viniciuscostass/sistema_irrigacao/Sistema de Irrigação e Caixas D'agua.pdf

# Sistema de Controle de Nível de Tanques e

Irrigaçao Autom ˜ | atica ´

Igor Theotonio ˆ
Instituto de Computaçaõ
Universidade Federal de Alagoas Maceio, Brasil ´
icat@ic.ufal.br

Marcos Vinícius Costa
Instituto de Computaçaõ
Universidade Federal de Alagoas Maceio, Brasil ´
mvsc@ic.ufal.br

Resumo—O artigo descreve a implementaçao de um sistema ˜
de controle de nível de tanques e irrigaçao autom ˜ | atica realizado ´
com Arduíno Genuíno Uno, construído como projeto final para
as disciplinas de Instrumentaçao Eletr ˜ | onica e Microcontroladores ˆ
e suas aplicaçoes do curso de Bacharelado em Engenharia de ˜ Computaçao - IC/UFAL. ˜
Palavras-chave—arduino, | sensores, | bomba | hidraulica, ´
irrigaçao, n ˜ | ível
I. INTRODUÇ AÕ

Com o avanço das tecnologias e civilizaçoes, diversos temas ˜ que outrora ignorados estao aparecendo com força total nas ˜ discussoes cotidianas e pensar em sustentabilidade foi ponto ˜ de partida na concepçao do projeto. ˜
Uma das maiores fontes de desperdício de agua no planeta ´
e a agricultura, sendo respons ´ | avel por mais de 70% do ´
consumo de agua do planeta [1]. Desta forma, o intutito ´ do projeto representado na figura 1 e demonstrar alternativas ´
financeiramente viaveis para diminuiç ´ | ao do uso de ˜ | agua na ´
agricultura de maneira simples, bem como demonstrar os conhecimentos adiquiridos nas disciplinas de instrumentaçaõ eletronica e microcontroladores. ˆ

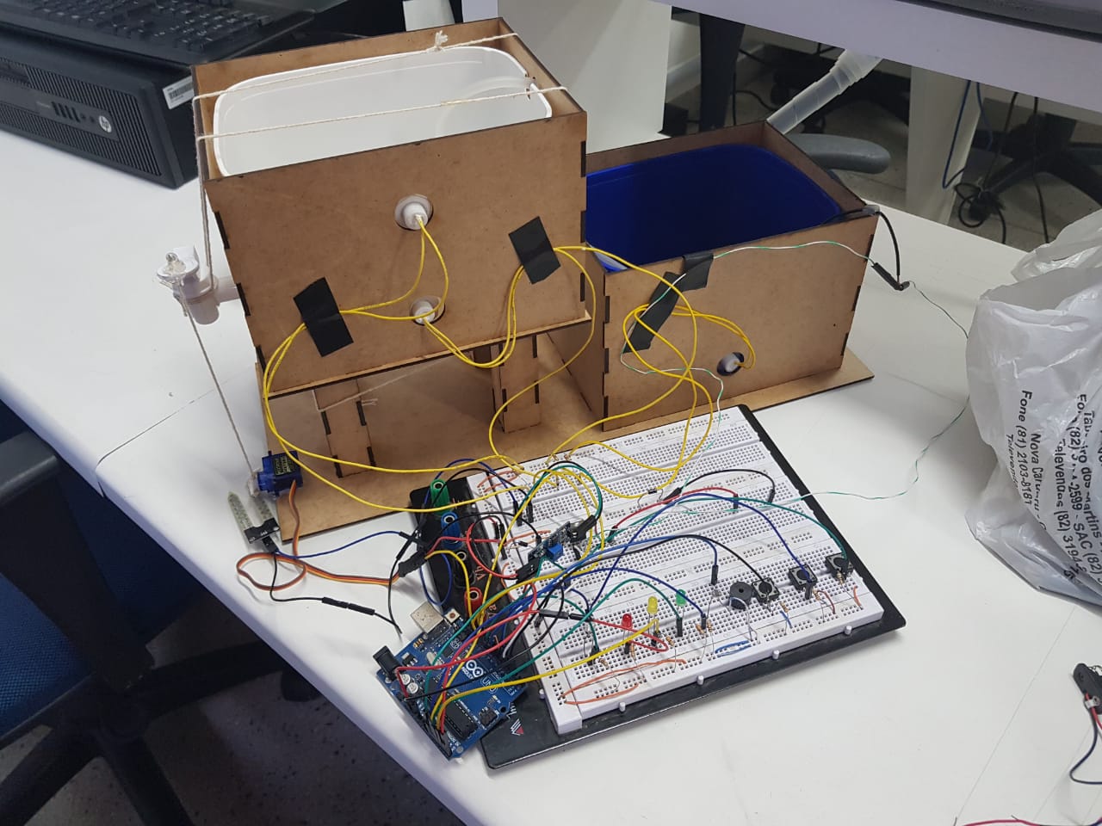
[picture p1: figure]

Figura 1. Prototipo ´

Pensando nisso, o sistema projetado analisa a umidade do solo em questao, o n ˜ ível de agua nos tanques e a luminosidade ´ do ambiente controlando assim a abertura da torneira e o funcionamento da bomba como forma de otimizar o gasto de agua e energia. ´

II. CONSTRUÇ AO DO ˜ | MODELO
A. Materiais Utilizados
Para elaboraçao deste projeto, foi necess ˜ | ario uma s ´ | erie de ´
materiais de modo geral (sendo eles eletronicos ou n ˆ | ao) para ˜
que os diversos requisitos fossem atendidos e o prototipo ´ aqui desenvolvido se assemelhe e considere o mais fielmente possível uma situaçao no mundo real. ˜
Dentre a lista de materiais utilizados, podemos citar o uso de sensores para mediçao de n ˜ ível de agua, umidade do solo ´ e luminosidade do ambiente; atuadores para movimentaçaõ
de agua entre os recipientes e controle de vaz ´ | ao de ˜ | agua ´
para irrigar uma planta, diversos outros elementos eletronicos ˆ simples como um transistor TIP122, resistores, diodos, leds e botoes para o controle e entendimento dos sinais do sistema; ˜
e tambem madeira, duas vasilhas de pl ´ | astico e uma torneira ´
de filtro para a montagem do prototipo f ´ | ísico.
1) Descriçao dos Sensores: ˜ | Para um acompanhamento
preciso de cada situaçao pass ˜ | ível de acontecer referente aos
modos de operaçao do sistema de irrigaç ˜ | ao, foram necess ˜ | arios ´
o uso de tres tipos de sensores diferentes, onde cada um ˆ aplicado em uma parte diferente do projeto contribuiu para o funcionamento como um todo. Os sensores utilizados para implementaçaõ

1 do sistema foram de nível, umidade e luminosidade. A seguir serao abordados cada um desses sensores ˜ de forma mais detalhada, assim como suas especificaçoes e ˜ casos de uso.
- Sensor de luminosidade (fotoresistor LDR): usado para verificar se os níveis de luminosidade estao adequados ˜ para irrigaçao, ou seja, nem podem estar muito elevados, ˜ o que indicaria um elevado nível de raios solares emitidos, ou nem muito baixos o que indicaria a noite, que
nao s ˜ | ao consideradas bons momentos para irrigaç ˜ | ao [2]. ˜
A sigla significa Light Dependent Resistor, em por-
tugues Resistor Dependente de Luz, que como o pr ˆ | oprio ´
nome diz, se trata de um resistor cuja resistencia varia ˆ conforme a quantidade de luz que incide sobre ele como
1Codigo: https://github.com/viniciuscostass/sistema ´ | irrigacao

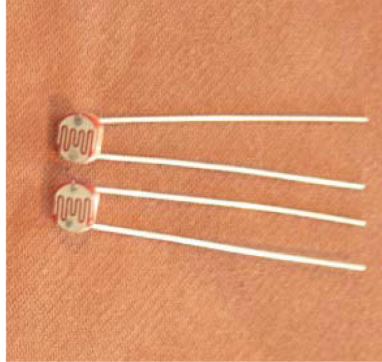
[picture p2: figure]

Figura 2. Sensor de luminosidade

observamos na figura 2. Essa variaçao ocorre de forma ˜ inversamente proporcional, ou seja, quanto maior a in-
tensidade de luz menor sera a resist ´ | encia, portanto maior ˆ
sera a tens ´ | ao medida em seus terminais [3]. ˜
O sensor trabalha em ambientes com uma faixa de temperatura entre -30º e 70ºC, sua resistencia pode atingir ˆ 1MΩ quando a luminosidade emitida chega a 0 lux, apresentando comportamento linear em um grafico Lu- ´ minosidade x Resistencia, podendo apresentar um erro ˆ aleatorio de 0,1 como observado na figura 3. Com essas ´ características e um baixo custo, se fez um equipamento essencial para o desenvolvimento do prototipo em ´ questao. ˜
- Sensor de nível: equipamento muito simples de ser usado como apresentado na figura 4, bastante utilizado em
aplicaçoes reais como caixas d’ ˜ | agua, reservat ´ | orios, tan- ´
ques etc. Seu funcionamento consiste na movimentaçaõ
de uma pequena boia com um ferrite que, quando a ´ | agua ´
faz ela flutuar, os dois terminais dos fios passam a ter contato (de modo semelhante a um reed switch) [5]. Dessa forma, para saber se o líquido chegou a nível de-
sejado e necess ´ | ario apenas saber se o circuito est ´ | a aberto ´
ou fechado, uma vez que esse sensor se comporta como
uma chave de modo que se a boia estiver mais pr ´ | oxima da ´
haste, o contato estara fechado. Caso contr ´ | ario, o sensor ´
se comportara de forma an ´ | aloga a uma chave aberta. ´
Esse sensor trabalha a uma tensao e corrente m ˜ | aximas ´
de, respectivamente, 24V e 50mA, sendo totalmente compatível com o Arduíno, e portanto, uma boa opçao a ˜ ser utilizada no prototipo desenvolvido. ´
Vale lembrar que seu modo de atuaçao depende da ˜ forma como foi instalado, em que especificamente para

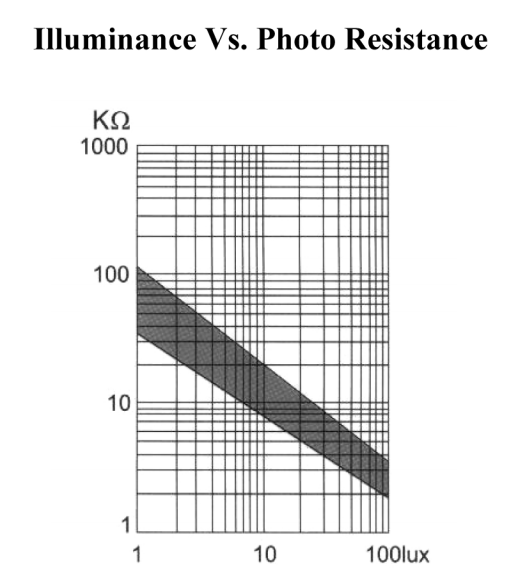
[picture p3: figure]

Figura 3. Luminosidade x Fotoresistencia ˆ

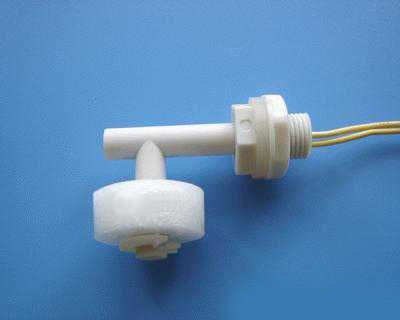
[picture p4: figure]

Figura 4. Sensor de nível

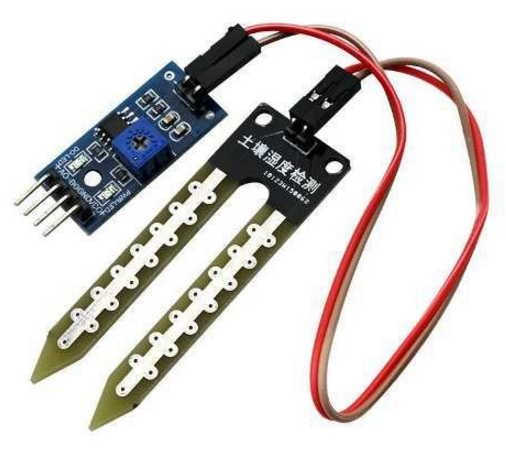
[picture p5: figure]

Figura 5. Sensor de umidade do solo

este projeto, um dos tres sensores foi instalado de forma ˆ invertida pelo fato de se localizar em uma area muito ´
proxima a base inferior do recipiente, permitindo ent ´ | aõ
uma maior margem de trabalho para sua mediçao. ˜
- Sensor de umidade: e uma sonda que mede o n ´ | | ível de
umidade da terra. A partir desse dispositivo e que ser ´ | á
verificado se a plantaçao estar ˜ | a necessitando de ´ | agua ou ´
nao, sendo este o respons ˜ | avel por atuar diretamente no ´
servomotor, abrindo ou fechando a torneira para controlar a passagem de agua do recipiente para a terra. ´
Este sensor e composto por um componente receptor e ´ comparador de sinal e a sonda que fica enterrada na terra, captando variaçoes de umidade no local, e pode operar ˜
de forma analogica ou digital, sendo a forma anal ´ | ogica ´
se comportando de forma linear em relaçao a quantidade ˜
de agua presente no meio. Na forma digital a operaç ´ | aõ
e realizada em conjunto com o comparador (LM393), ´ de maneira que e especificado apenas com sinais altos ´
ou baixos se o meio contem sinais de umidade ou n ´ | ao. ˜
Usando essa forma de abordagem, que foi adotada para este projeto, e poss ´ ível controlar apenas como chave (ON/OFF) se a torneira vai ser acionada [4].
O princípio de funcionamento e simples. Como mos- ´ trado na figura 5, o modulo possui duas hastes com ´ dois longos contatos cada. Trata-se de um sensor cuja
resistencia el ˆ | etrica varia de acordo com a umidade do ´
solo. Assim, quanto mais umido estiver o solo, menor ´ a resistencia do sensor. Quanto mais seco, maior a re- ˆ
sistencia do sensor. Se a sa ˆ | ída for digital, ela apresenta
nível alto quando o solo estiver seco, e nível baixo caso contrario. ´
Para este tipo de saída, um potenciometro ˆ | e utilizado ´
para controlar a sensibilidade do sensor, ou seja, quanto

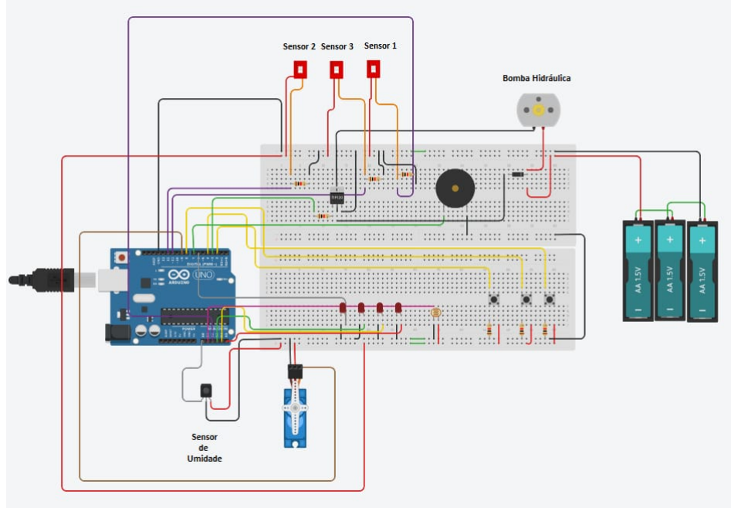
[picture p6: figure]

Figura 6. Representaçao do circuito ˜

de umidade e necess ´ | aria para concluir que o solo est ´ | á
umido. A sa ´ | ída analogica pode variar de 300mV ´ | a 700mV `
em solo umido, 700mV ´ | a 950mV em solo encharcado, e `
0 a 300mV em solo seco.
2) Custos Envolvidos: Fazendo um levantamento dos custos gerados pelos principais elementos do prototipo desenvol- ´ vido, e poss ´ ível ter uma noçao de que um projeto desse porte ˜ pode ser implementado com um custo relativamente baixo,
sendo assim viavel para uma futura aplicaç ´ | ao no mercado. ˜
Segue abaixo na tabela I os valores dedicados aos materiais mais relevantes aqui utilizados.

Tabela I
CUSTOS DO PROTOTIPO ´
Material | Custo Unitario (R$) ´ | Quantidade | Custo Total (R$)
Mini bomba hidraulica | 20,00 | 1 | 20,00 ´
Sensor horizontal de nível | 18,90 | 3 | 53,70
Sensor de umidade de solo | 9,40 | 1 | 9,40
Torneira de filtro | 5,00 | 1 | 5,00
Servo motor | 18,90 | 1 | 18,90
Estrutura em MDF | 50,00 | 1 | 50,00
Outros componentes | 20,00 | 1 | 20,00
| | Total | 181,00
B. Esquematico do Circuito ´
Uma representaçao virtual simples do circuito montado no ˜
prototipo est ´ | a na figura 6. Infelizmente n ´ | ao haviam 100% ˜
dos componentes necessarios para a montagem virtual e por ´
isso foi feita uma adaptaçao na representaç ˜ | ao dos sensores ˜
de nível que estao representados como chaves (j ˜ | a que assim ´
funcionam), os LEDs que estao todos da mesma cor e o ˜ sensor de umidade que esta representado como um receptor ´ infravermelho, apenas pela necessidade dos tres pinos. ˆ
C. Modelo da Estrutura em Madeira
A ideia geral por tras da estrutura em madeira ´ | e construir ´
com o menor custo uma estrutura visualmente interessante,

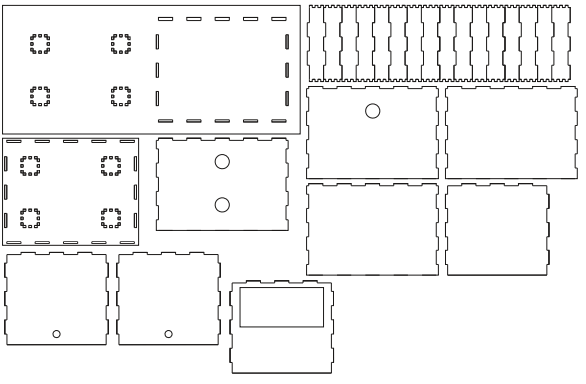
[picture p7: figure]

Figura 7. Modelo para corte a laser em MDF

funcional e com baixo custo. Por esse motivo, como podemos ver na figura 7 foi projetada como uma estrutura inferior com duas passagens circulares, um para passagem do pequeno
tubo acoplado a minibomba e outro para o sensor de n ` | ível e
uma estrutura superior no mesmo formato com tres passagens ˆ circulares para o tubo da miniboma e dois sensores e uma
retangular para torneira de filtro. O reservatorio superior est ´ | á
apoiado em quatro pilares e todo o modelo foi projetado para se encaixar perfeitamente, aumentando a estabilidade e a precisao e diminuindo a necessidade do uso de cola. ˜

III. FUNCIONAMENTO DO MODELO
O prototipo apresentado foi projetado para funcionar em ´ dois modos de operaçao, sendo um deles baseado nas respostas ˜ dos sensores e o outro possibilitando operaçao humana aliada ˜
as respostas de alguns dos sensores. Para fins de explicaç ` | aõ
do funcionamento do modelo, consideraremos o sensor de nível do compartimento inferior como sensor de nível 01 e os sensores de nível inferior e superior do compartimento superior como sensores de nível 02 e 03 respectivamente.
Tambem, vale ressaltar a presença de 4 LEDs, 3 bot ´ | oes e 1 ˜
buzzer, onde temos um LED branco responsavel por indicar ´ o modo de operaçao do sistema (aceso = manual), um LED ˜ vermelho que indica o nível do reservatorio inferior (aceso ´ = baixo), um LED amarelo que indica o funcionamento da bomba (aceso = funcionando) e um LED verde que indica o
nível do reservatorio superior (aceso = cheio). J ´ | a o buzzer, ´ | é
acionado com o nível baixo do reservatorio inferior. ´
Um botaõ e respons ´ | avel por alterar o modo de funciona- ´
mento do sistema, e os outros dois ligam manualmente o servo motor(abre a torneira) e a bomba hidraulica. ´
A. Modo Automatico ´
No modo automatico a intenç ´ | aõ e que n ´ | ao haja necessidade ˜
alguma de interaçao humana para funcionamento do prot ˜ | otipo, ´
exceto para preenchimento do compartimento inferior que naõ esta conectado a nenhum tipo de rede hidraulica. ´
Assim, o sensor de nível 01 e respons ´ | avel por impedir ´
o funcionamento da bomba caso nao haja ˜ | agua em seu ´
reservat´ orio, evitando assim gastos desnecess ´ | arios de energia ´
e possíveis danos a bomba hidr ` | aulica funcionando sem ´ | agua. ´
O sensor de nível 03, por sua vez, e respons ´ | avel por impedir ´
que a agua do reservat ´ | orio superior transborde, ou seja, quando ´
seu nível esta alto, a bomba n ´ | ao ligada sob hip ˜ | otese alguma. ´
Ja o sensor de n ´ | ível 02 e respons ´ | avel por indicar se h ´ | á
ou naõ agua suficiente para irrigaç ´ | ao (se o n ˜ | ível esta alto o ´
suficiente para agua sair pela torneira) e caso o n ´ | | | ível esteja
baixo demais a bomba e ligada com mais força (respeitando ´ o sinal dos sensores de nível 01 e 03) do que caso nao esteja. ˜ Aliado ao funcionamento dos sensores de nível temos o sensor de umidade do solo, funcionando como sinal responsavel ´ pra controle do servo motor que abre e fecha a torneira de
irrigaçao. E temos tamb ˜ | em o sensor de luminosidade (LDR) ´
que impede a abertura da torneira quando a luz esta baixa, ou ´
seja, durante a ausencia de sol, visto que a irrigaç ˆ | ao norturna ˜
pode ocasionar doenças para a planta [2].
B. Modo Manual
O funcionamento em modo manual respeita o funciona-
mento dos sensores de nível 01 e 03, isto e,´ e imposs ´ | ível
ligar a bomba com o sensor 01 em nível baixo ou o sensor 03 em nível alto. Alem disso, os LEDs e buzzer funcionam ´ normalmente.
A diferença e que o sensor de umidade n ´ | aõ e mais res- ´
ponsavel pela abertura da torneira, nem o sinal do sensor ´ de nível 02 responsavel por acionar a bomba e nem o LDR ´ impede o funcionameno da torneira. O operador do sistema é
responsavel por abrir a torneira quando quiser atrav ´ | es de um ´
botao e ligar a bomba quando quiser (respeitando os sensores ˜
de nível 01 e 03) atraves de outro bot ´ | ao. ˜

IV. DIFICULDADES DE IMPLEMENTAÇ AÕ

A maior dificuldade enfrentada no desenvolvimento deste projeto foi relacionado a existencia de dois motores no projeto ˆ (servomotor para abertura da torneira de irrigaçao e a bomba ˜ hidraulica), de modo que ambos requerem altos valores de ´ corrente para o seu correto funcionamento e o Arduíno e capaz ´ de fornecer somente 50mA (sendo necessario pelo menos ´ 200mA so para a bomba). ´
Em um primeiro momento, existiu a possibilidade de ligar cada componente separadamente na placa microcontroladora, sendo a bomba hidraulica com a ajuda de um diodo e um ´ transistor TIP122, e o servomotor diretamente no Arduíno, pois este possui uma biblioteca para fazer com que o motor funcione de forma adequada. Entretanto, ao tentar ligar os dois motores diretamente no sinal de 5V do Arduíno, a ativaçao da bomba interferia diretamente no servo fazendo ˜ com que este desconsiderasse a posiçao angular a qual deveria ˜
estar, definida por codigo. Logo, foi conclu ´ | ído que nao existe ˜
corrente suficiente para alimentaçao dos dois motores atrav ˜ | es´
apenas dos pinos de 5V, e para evitar causar danos a placa ` controladora, decidiu-se optar por uma fonte de alimentaçaõ externa.
A partir disso, foi possível fazer uma alimentaçao com ˜ uma fonte de 5V, de modo que apenas a bomba hidraulica ´

seria alimentada externamente. O servomotor continuaria no Arduíno. Mas ainda sim o uso do transistor ainda se fazia necessario para controlar a velocidade em que a bomba atuaria ´ ou se ela estaria desligada. O sinal da base do transistor seria gerado a partir do PWM do Arduíno.
Inicialmente a estrategia correu como esperado, at ´ | e que no ´
decorrer do projeto, quando os sinais dos sensores e modos de operaçao da planta passaram a existir, foi verificado que ainda ˜ sim a rotaçao do motor influenciava no restante do circuito. ˜ O uso de diodos como foi mostrado na sessao II-B permitiu ˜ que esse problema fosse resolvido.
A nao disposiç ˜ | ao de elementos eletr ˜ | onicos tamb ˆ | em se ´
fez um fator importante para causa de impedimentos na
implementaçao, principalmente no que se diz respeito ˜ | a sa ` | ída
de agua da caixa para a planta, onde o mais ideal seria a ´
instalaçao de uma v ˜ | alvula solen ´ | oide para controlar a vaz ´ | ao de ˜
agua destinada para irrigaç ´ | ao. Como se tratava de um material ˜
no qual sua aquisiçao seria complicada, principalmente por ˜
questoes de custo e tempo, adotou-se uma soluç ˜ | ao envolvendo ˜
uma torneira de filtro de agua que seria puxada em sua extre- ´ midade por um barbante ligado ao servomotor para controlar a vazao de ˜ agua a ser expelida. ´
Um outro fator que atrasou relativamente o andamento do projeto foi relacionado as grandezas envolvidas para fazer o ` controle do sistema, mais especificamente, luz e umidade, que por se tratarem de grandezas cujas mediçoes n ˜ ao podem ser re- ˜ alizadas de forma trivial, apenas com equipamento específico, dificultou o processo de calibraçao dos sensores, fazendo com ˜ que fossem adotadas formas de mediçao digitais, baseadas ˜ em condiçoes extremas para cada uma das grandezas para ˜ que assim pudesse ser analisado o comportamento do sistema como um todo.
Por fim, o fato de o projeto ter como base principal o uso de
agua, subst ´ | ancia extremamente cr ˆ | ítica em um laboratorio de ´
eletronica fez com que os projetistas se limitassem em relaç ˆ | aõ
a alimentaç ` | ao dos atuadores, o que tornava todo o in ˜ | ício de
trabalho um processo grande para preparaçao da bancada de ˜ trabalho. Se fez necessario o uso de cada elemento de forma ´ separada para evitar quaisquer danos a outros equipamentos presentes nas proximidades.
V. RESULTADOS E CONCLUSOES ˜

Foi possível verificar apos a montagem como um todo ´ desse projeto quais dificuldades seriam encontradas ao aplicar isso no mundo real por diversos fatores. O primeiro seria
em questao da alimentaç ˜ | ao dos motores, que como visto ˜
neste documento, usando a abordagem com o Arduino se tornaria uma tarefa mais complicada visto que seria necessaria ´ a presença de fontes de alimentaçao externa, que a depender ˜ da fonte poderia elevar relativamente os custos com materiais para desenvolvimento.
Como se trata de um projeto de conclusao de disciplina, o ˜ fator tempo impediu que pesquisas mais avançadas em formas de como melhorar isso ou ate mesmo optar por melhores ´
soluçoes, visto que existem equipamentos espec ˜ | | | íficos para
controle de vazao de ˜ | agua, que podem ser mais vi ´ | aveis tamb ´ | em´
no quesito consumo de energia.
Um outro problema na implantaçao do sistema seria refe- ˜
rente a terra na qual seria realizada a an ` | | | | | | alise de umidade. ´
A presença de adubos ou outros aditivos pode influenciar na condutividade do meio afetando assim a calibraçao do sensor ˜ adotado, que passaria a enviar dados incorretos para o restante do sistema.
No entanto, de modo geral, o desenvolvimento desse projeto se apresentou de forma bastante construtiva, onde pode-se ˆ explorar mais as capacidades do Arduino assim como seus acessorios, que em conjunto podem gerar um sistema inteli- ´ gente a ser aplicado em tarefas do cotidiano.
Foi possível trabalhar bem com as limitaçoes de hardware ˜ impostas a necessidade de baixo custo fazendo com que ` soluçoes alternativa tomassem espaço no decorrer do desen- ˜ volvimento. Um exemplo a ser citado e o uso da biblioteca ´ do servomotor no arduíno, que desabilita quaisquer tentativas de uso do Timer 1 deste mesmo componente. Foi necessario ´ utilizar o Timer 2 que trabalha com apenas 8 bits para realizar mediçoes de tempo na casa dos 10 segundos. ˜
Por fim, vale ressaltar que outras pesquisas ja foram reali- ´ zadas na area, que podem, inclusive, serem consideradas para ´ melhoria e ampliaçao do trabalho aqui desenvolvido, de modo ˜ que se torne um sistema de irrigaçao robusto preparado para ˜ aguentar as diversidades do mundo real e serem comercializados melhorando assim a qualidade de plantios existentes pelo país.

REFERENCIAS ˆ

[1] WALBERT, Allan. Agricultura e quem mais gasta ´ | agua no Brasil e no ´
mundo. Disponível em: <http://www.ebc.com.br/noticias/internacional/2013/03/agricultura-e-quem-mais-gasta-agua-no-brasil-e-no-mundo>. (http://www.ebc.com.br/noticias/internacional/2013/03/agricultura-e-quem-mais-gasta-agua-no-brasil-e-no-mundo) Acesso em: 15 de outubro de 2018.
[2] O | MEU | JARDIM. | As | 5 | melhores | formas | de | regar | o
jardim. | Disponível | em: | <https://omeujardim.com/artigos/
5-melhores-formas-regar-jardim>. (https://omeujardim.com/artigos/5-melhores-formas-regar-jardim) Acesso em: 15 de outubro de 2018.
[3] MOTA, Allan. Sensor de Luz – Aprendendo a usar o LDR com Arduino. Disponível em: <https://portal.vidadesilicio.com.br/sensor-de-luz-com-ldr/>. (https://portal.vidadesilicio.com.br/sensor-de-luz-com-ldr/) Acesso em: 15 de outubro de 2018.
[4] VIDAL, Vitor. Automaçao de sistema de irrigaç ˜ | ao: Sensor de umidade ˜
e valvula solen ´ | oide. Dispon ´ | ível em: <http://blog.eletrogate.com/
automacao-de-sistema-de-irrigacao-sensor-de-umidade-e-valvula-solenoide/>. (http://blog.eletrogate.com/automacao-de-sistema-de-irrigacao-sensor-de-umidade-e-valvula-solenoide/) Acesso em: 15 de outubro de 2018.
[5] ROBOCORE. Sensor de Nível de Agua. Dispon ´ | ível em: <https://www.
robocore.net/loja/produtos/sensor-de-nivel-de-agua.html#descricao>.
Acesso em: 15 de outubro de 2018.
